MaxDYi/JD-Signal/6.Docs/问题记录/JD_Signal PCB问题.md

### V1.0

#### 问题：

1. Debug接口奇数与偶数接口需要对调。

2. 片上DAC输出未滤波。

3. ULN2003输出端未接外部电源。

4. RST键上端接VDD，无法复位。

### V1.1

#### 修改：

1. Debug接口奇数与偶数接口需要对调。
2. Debug接口增加标注丝印。
3. 片上DAC输出信号增加一级有源滤波。
4. 修改ULN2003 外部电源连接。
5. 修改RST键连接。
7. LED限流电阻改为1kΩ。
8. 增加VBAT供电电池。
9. 屏幕固定位置。

#### 问题：

1. ADC使用了低速通道。
2. DAC输出U4低通滤波器错误。
3. PGA两级的耦合电容删除。
4. U8与U10的封装过大。
5. CR2032电池座缺少定位孔。

### V1.2

#### 修改：

更换ADC通道。

删除PGA的SPI1_MISO引脚，改为只发送模式。

修正U4低通滤波器电路。

PGA两级的耦合电容替换为0欧电阻。

修改SWD时钟的丝印为SCK。

增加BOOT0按键。
