MaxDYi/JD-Signal/6.Docs/问题记录/SD卡存储说明.md

# SD卡存储说明

SD卡存储原始数据与计算结果。

原始数据与计算结果均保存至SD卡根目录的文件夹中，文件夹以任务开始时的时间戳命名，以系统RTC时间为准。

命名格式“YYYY\MM\DD_hh-mm-ss”。

## 1.原始数据

## 2.计算结果
