MaxDYi/JD-Signal/2.Hardware/JD-Signal-ASM/JD-Signal-BOM.xlsx

Comment | Description | Designator | Footprint | Quantity
1uF | 贴片电容/MLCC电容 | C1, C2, C3, C5, C6, C8, C10, C15, C17 | C0603_M | 9
100nF | 贴片电容/MLCC电容 | C4, C13, C14, C16, C18, C19, C20, C21, C22, C23, C26, C27, C28, C29, C30, C31, C32, C33, C34, C35, C36, C37, C38, C39, C41, C42 | C0603_M | 26
1.5pF | 贴片电容/MLCC电容 | C7, C9 | C0603_M | 2
8pF | 贴片电容/MLCC电容 | C11, C12 | C0603_M | 2
2.2uF | 贴片电容/MLCC电容 | C24, C25 | C0603_M | 2
1nF | 贴片电容/MLCC电容 | C40 | C0603_M | 1
VS10BQ015HM3 | 肖特基二极管 | D1, D2, D3, D4 | SMB | 4
1N4148 | High Conductance Fast Diode | D5, D6 | SOD-123 | 2
DEBUG PAD | 调试断点焊盘 | DE1, DE2, DE3 | DEBUG_B | 3
ESD | 瞬态电压抑制二极管 | DR1, DR2, DR3, DR4, DR5, DR6, DR7, DR8, DR9 | 0402 | 9
10uF/6.3V | 贴片钽电容 | E1, E2, E3, E4 | C_3216 | 4
IPORT-3 | IPORT-3 | IPORT1 | IPORT | 1
TF_Card | TF卡座 | J1 | Micro SD | 1
236-402 | No Description Available | J2, J3, J4, J5, J6, J7, J8, J9, J10, J11, J12, J13 | CONN_236-402_WAG | 12
CON-18P | 18P连接器 | JP1 | FPC0.5-WT-18P | 1
Header 5X2 | 5*2P接插件 | JP2 | HDR2.54-LI-2x5P | 1
HDR-1X3 | 3P接插件 | JP3 | HDR2.54-LI-3P | 1
RED | 贴片LED | LED1, LED13, LED14, LED15 | LED0603_R | 4
BLUE | 贴片LED | LED2, LED16 | LED0603_R | 2
GREEN | 贴片LED | LED3, LED4, LED5, LED6, LED7, LED8, LED9, LED10, LED11, LED12 | LED0603_R | 10
DC5V | 蜂鸣器 | LS1 | BEEP 5x9x5.5 | 1
S8550 | PNP General Purpose Amplifier | Q1 | SOT23 | 1
AO3400A | P-Channel JFET | Q2 | SOT23 | 1
S8050 | NPN General Purpose Amplifier | Q3 | SOT23 | 1
10K | 贴片电阻 | R1, R4, R5, R6, R7, R11, R12, R14, R21, R23, R26, R32, R34, R37, R38, R57 | R0603_M | 16
1K | 贴片电阻 | R2, R3, R35, R43, R46, R47, R48, R49, R54, R55, R60, R61, R62, R64, R65, R74, R79 | R0603_M | 17
47K | 贴片电阻 | R8, R9, R10, R24, R25 | R0603_M | 5
100K | 贴片电阻 | R13, R20 | R0603_M | 2
22R | 贴片电阻 | R15, R16, R17, R18, R19, R22 | R0603_M | 6
330R | 贴片电阻 | R27, R28 | R0603_M | 2
0R | 贴片电阻 | R29, R36, R40, R41, R42, R44, R45, R52, R53, R56, R59, R63, R66, R67, R69, R70, R71 | R0603_M | 17
0.01R | 贴片电阻 | R30, R31, R33 | HS25 | 3
10K | 贴片电阻 | R39 | R1210_M | 1
5.1K | 贴片电阻 | R50, R51 | R0603_M | 2
200K | 贴片电阻 | R58 | R0603_M | 1
470R | 贴片电阻 | R68, R77 | R0603_M | 2
0R | 贴片电阻 | R72, R73, R75, R76 | AXIAL0.5-1/2W | 4
22K | 贴片电阻 | R78 | R0603_M | 1
4.7K | 贴片电阻 | R80 | R0603_M | 1
G6B-2114P-US 12DC | No Description Available | RLA1, RLA2, RLA3, RLA4, RLA5 | RELAY_G6B-2114P_OMR | 5
VBAT | 纽扣电池 | S2 | CR2032 BS-5 | 1
M3铜柱 | 铜柱 | SP1, SP2, SP3, SP4 | M3x4+6_N | 4
4x4x1.5 | 贴片4x4轻触开关 | SW1, SW2, SW3 | SW SMD-3*6*2.5 | 3
DIP-SW-4P | 4路编码开关 | SW4 | SW DIP-4P | 1
TEST | 测试点 | TP1, TP2, TP4, TP6, TP7, TP8, TP9, TP10, TP11 | TEST 1.6 | 9
LT6658AIDE | No Description Available | U1 | MSOP16 | 1
STM32H750VBT6 | No Description Available | U2 | LQFP100-14*14 | 1
LT1632IS8 | No Description Available | U3, U4 | SO-8 | 2
AD620AN | CI-AD620AN | U5, U7, U12, U13 | SOIC-8 | 4
OPA548T-1 | No Description Available | U6 | TO-220-7 - 90*45 | 1
LTC6912IGN-1 | No Description Available | U8, U10 | SSOP-16 | 2
ULN2003AD | No Description Available | U9 | SOP16 | 1
CH340N | USB转串口芯片, 内置晶振 | U11 | SOIC-8 | 1
TYPE-C 2.0 -16P | USB2.0_Type-C_16Pin母座 | USBC1 | USB-C-SMD_16P | 1
AMS1117-3V3 | 三端稳压芯片 | V1, V2 | SOT89_L | 2
32.768KHz | 2脚无源晶振(谐振器） | X1 | XTAL-3215-2P | 1
12M | 4脚无源晶振(谐振器） | X2 | XTAL-3225-4P | 1
