MaxDYi/JD-Signal/2.Hardware/JD-Signal-PRJ/JD-Signal-SCH-V2.0.pdf

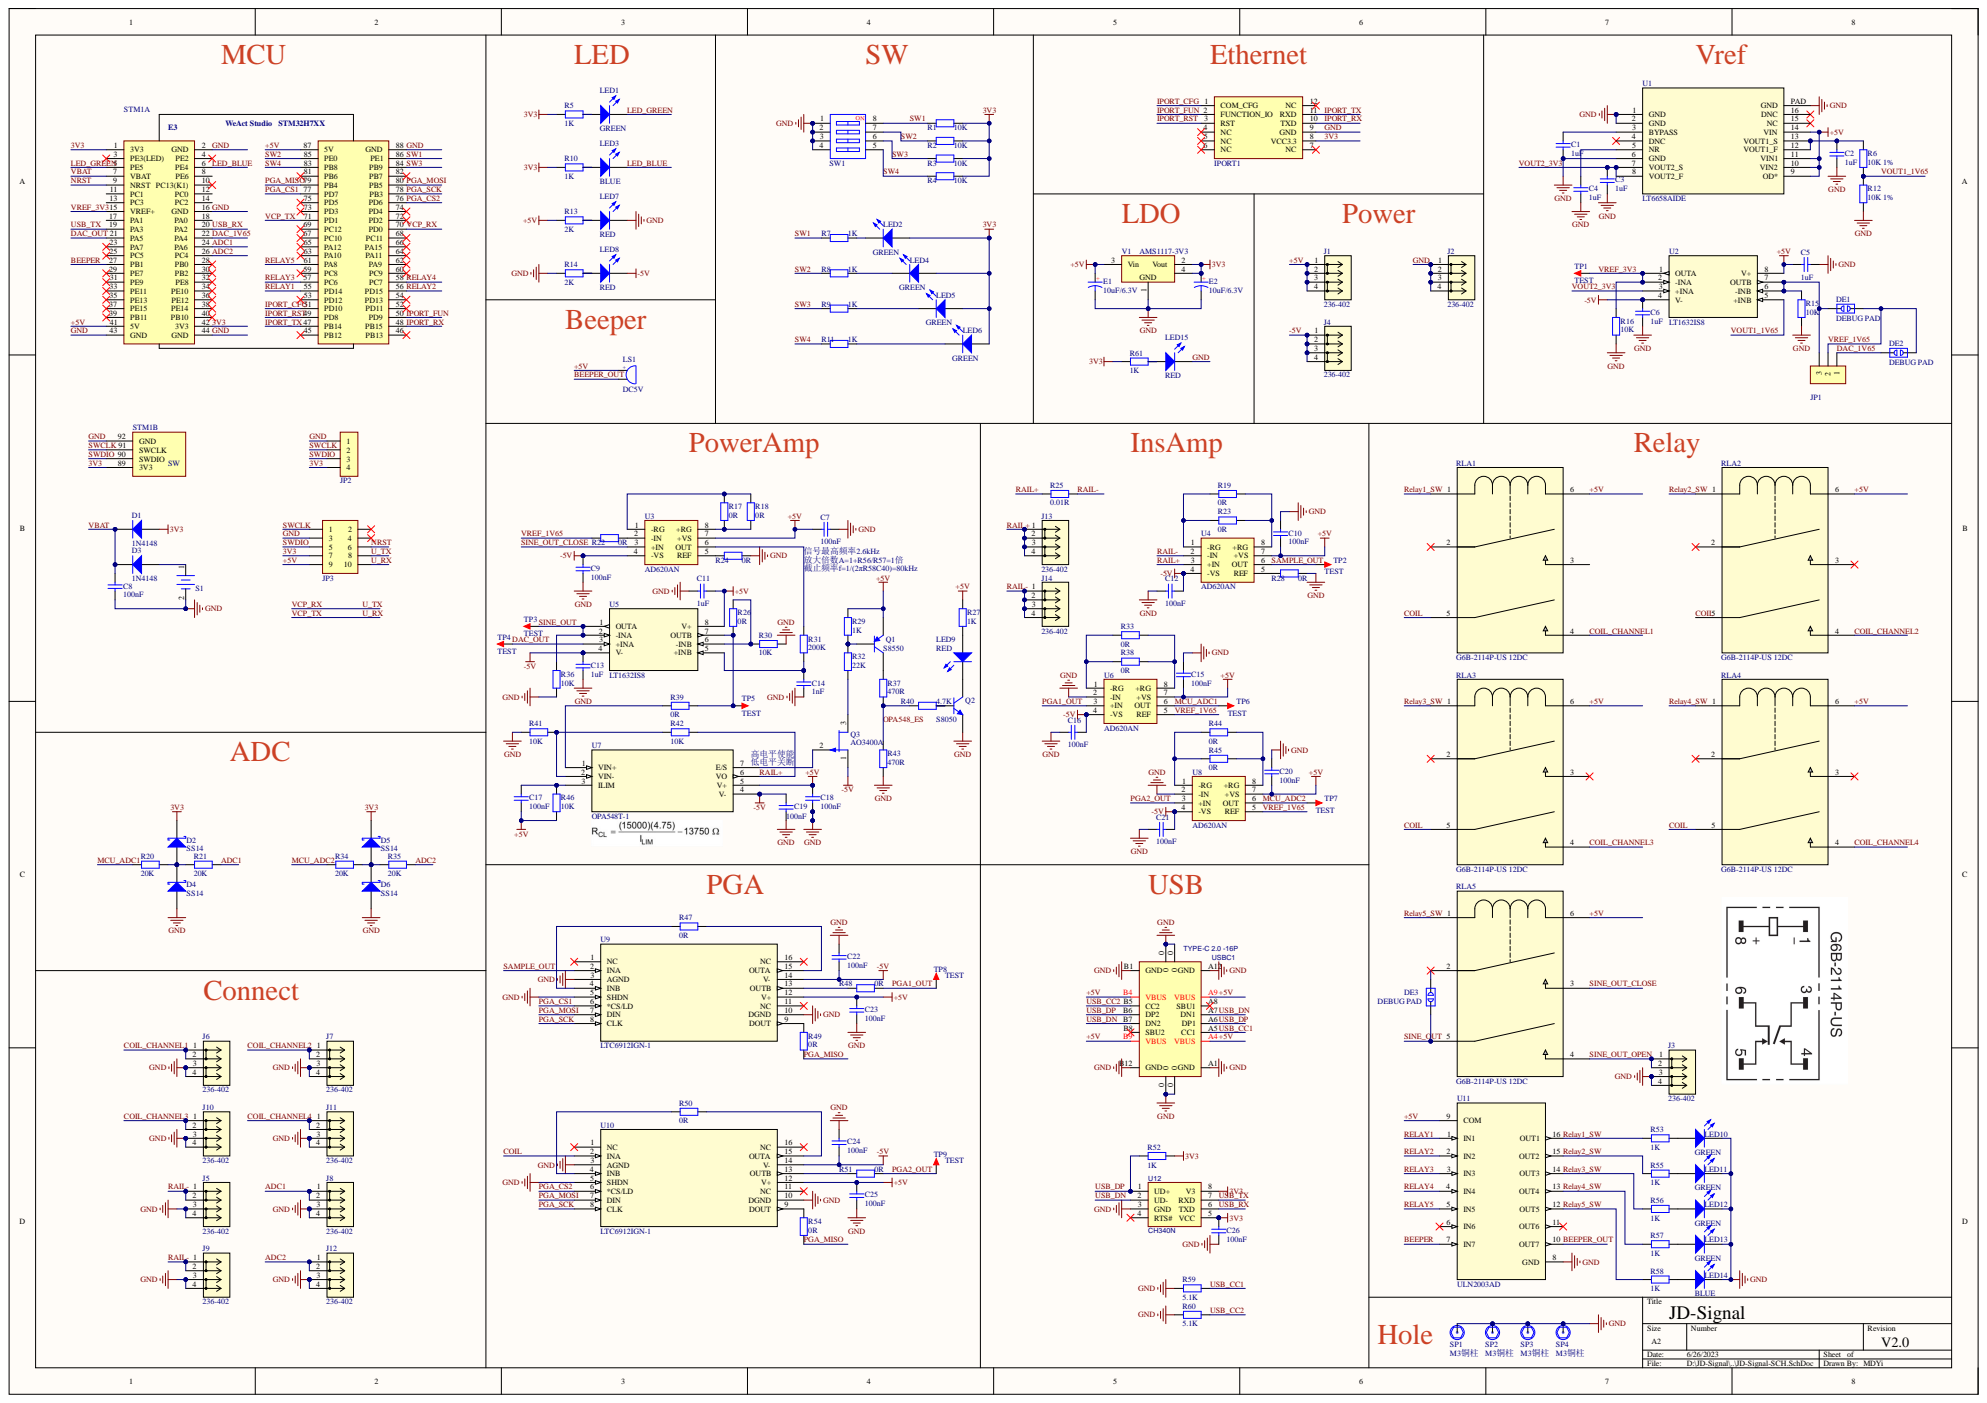
[picture p1: page 1]
