MaxDYi/JD-Signal/2.Hardware/JD-Signal-ASM/JD-Signal-V1.2-装配图.pdf

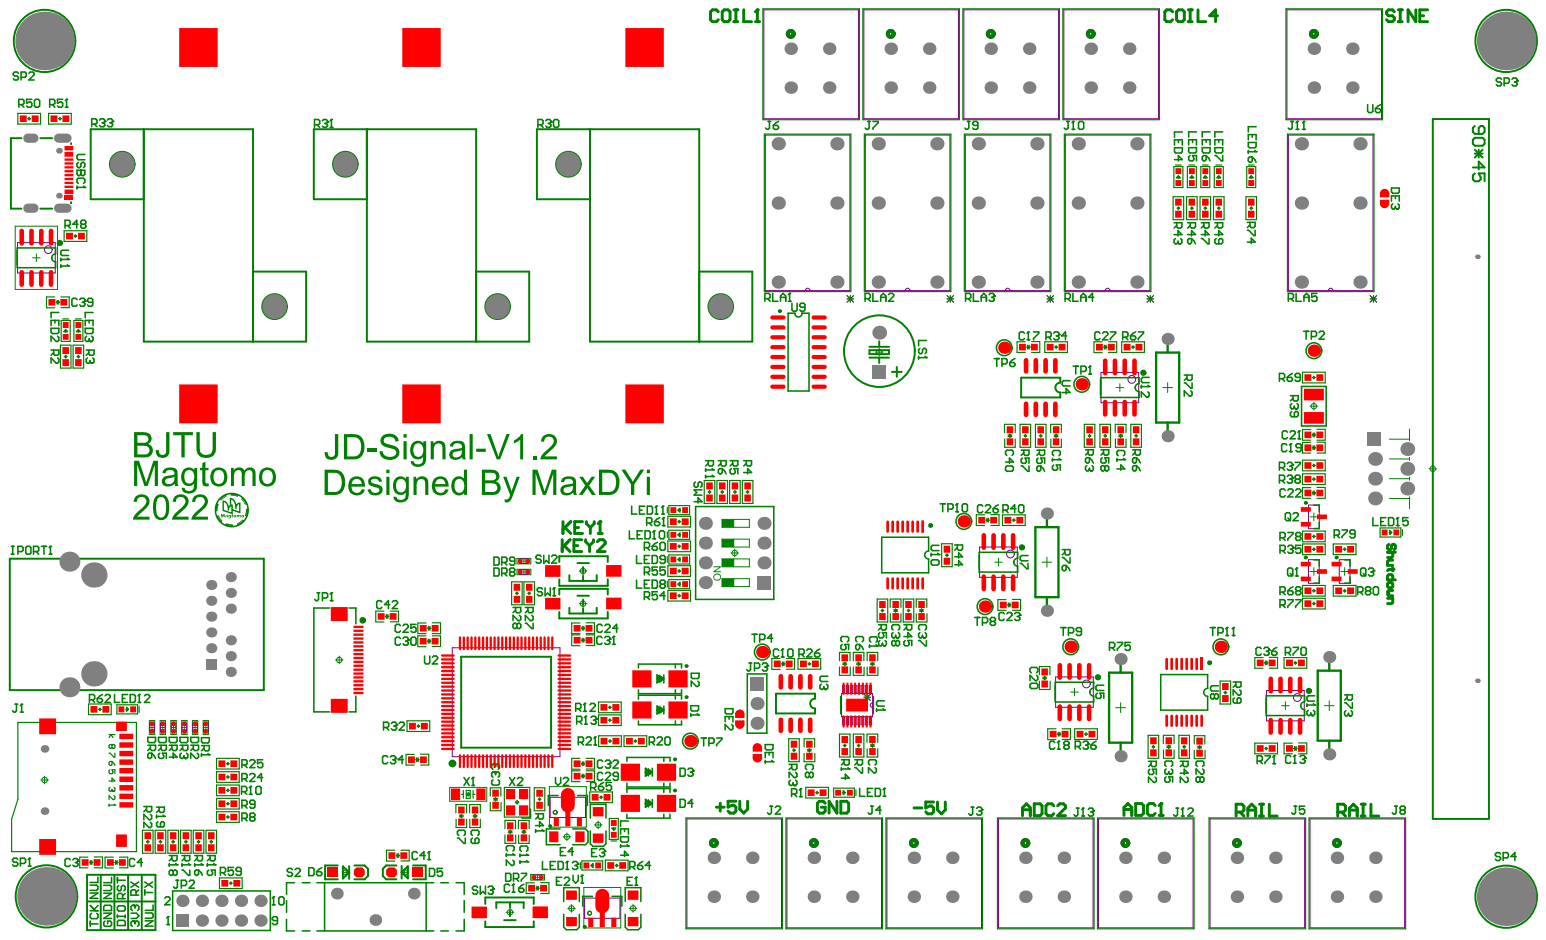
[picture p2: page 1]

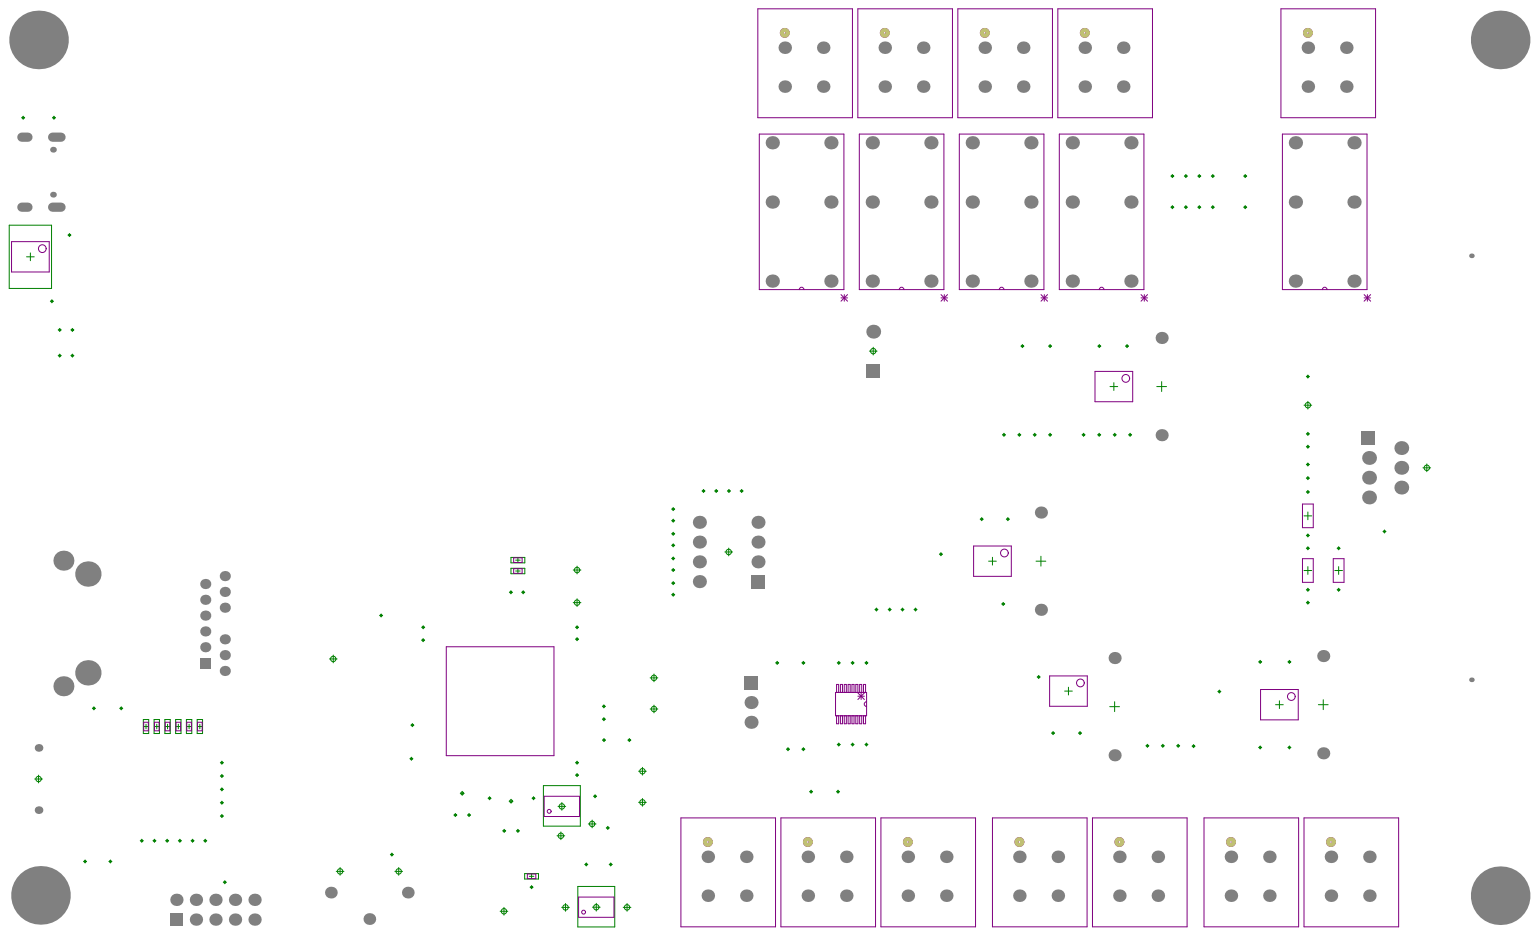
[picture p3: page 2]
