MaxDYi/JD-Signal/6.Docs/电路图/JD-Signal-SCH_V1.2.pdf

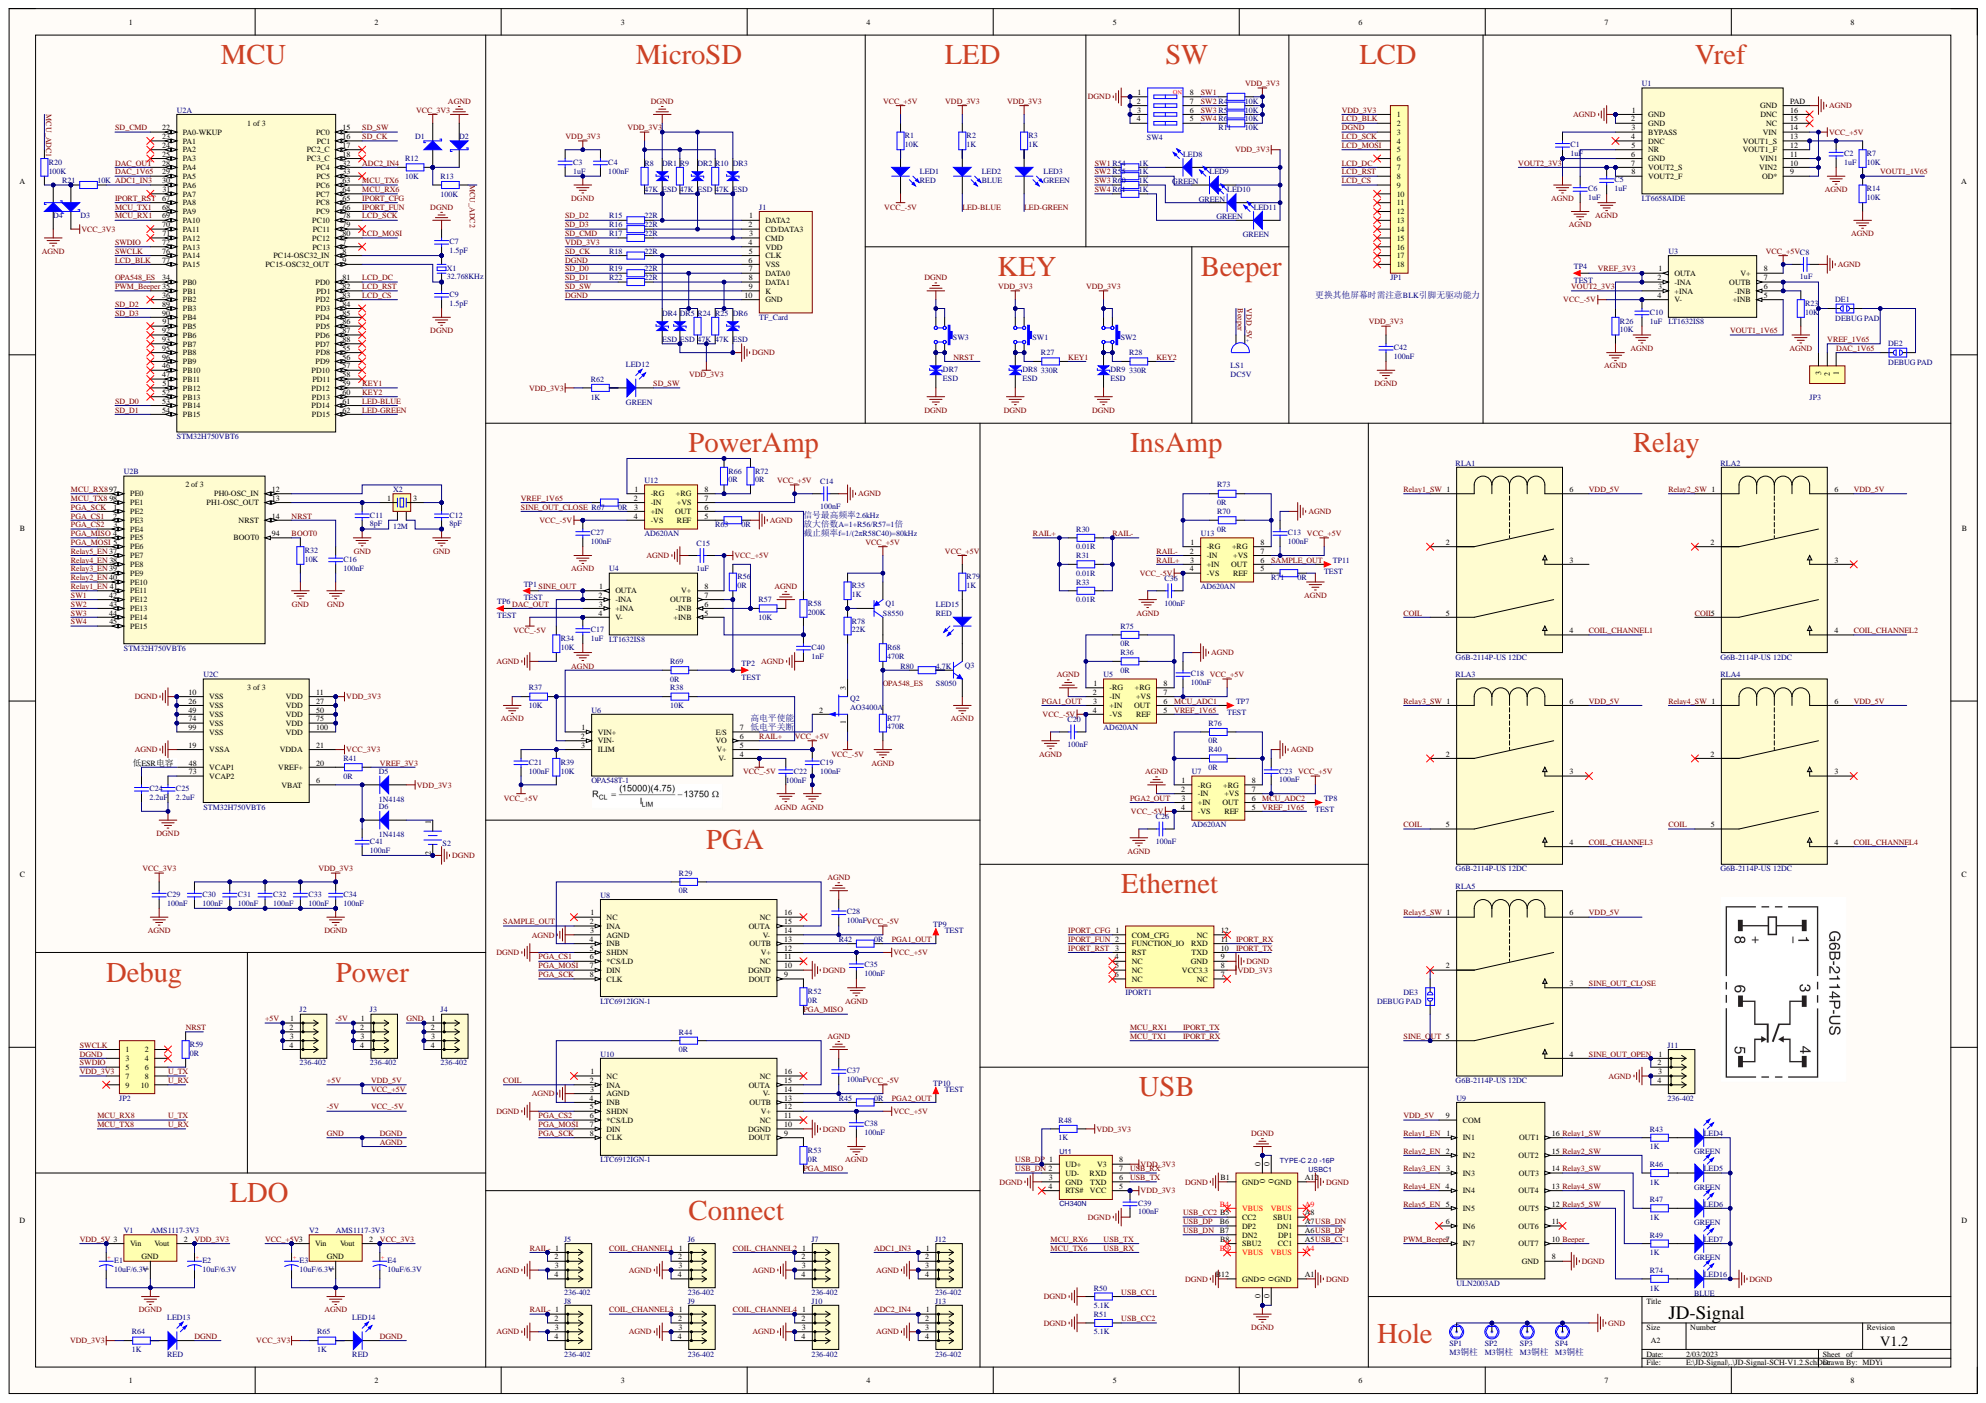
[picture p4: page 1]
