MaxDYi/JD-Signal/6.Docs/电路图/JD-Signal-SCH_V1.0.pdf

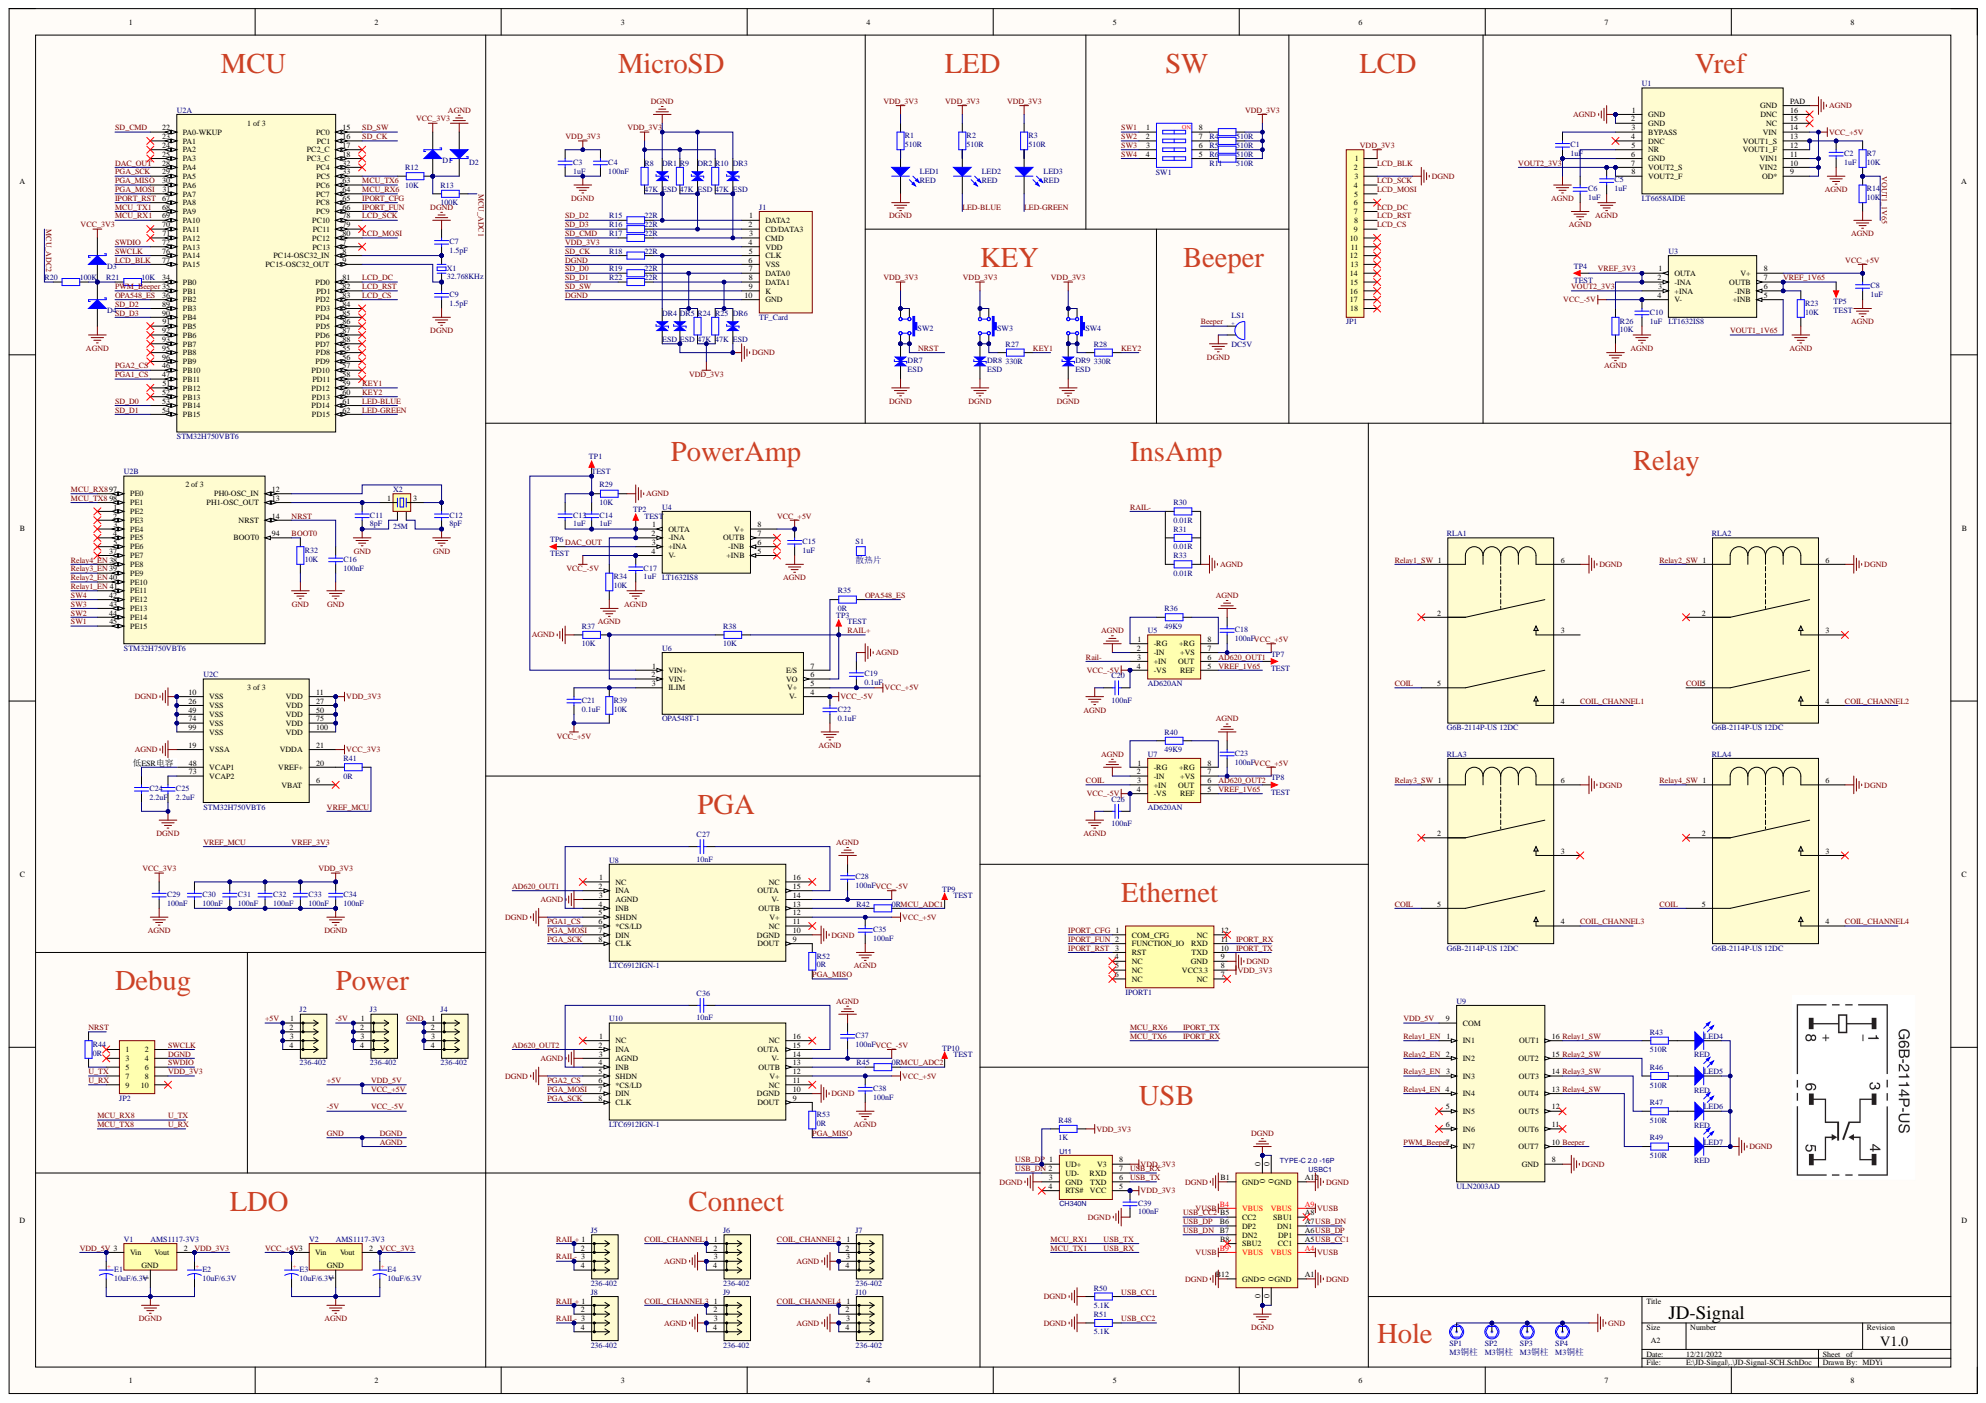
[picture p5: page 1]
