MaxDYi/JD-Signal/6.Docs/电路图/JD-Signal-SCH_V1.1.pdf

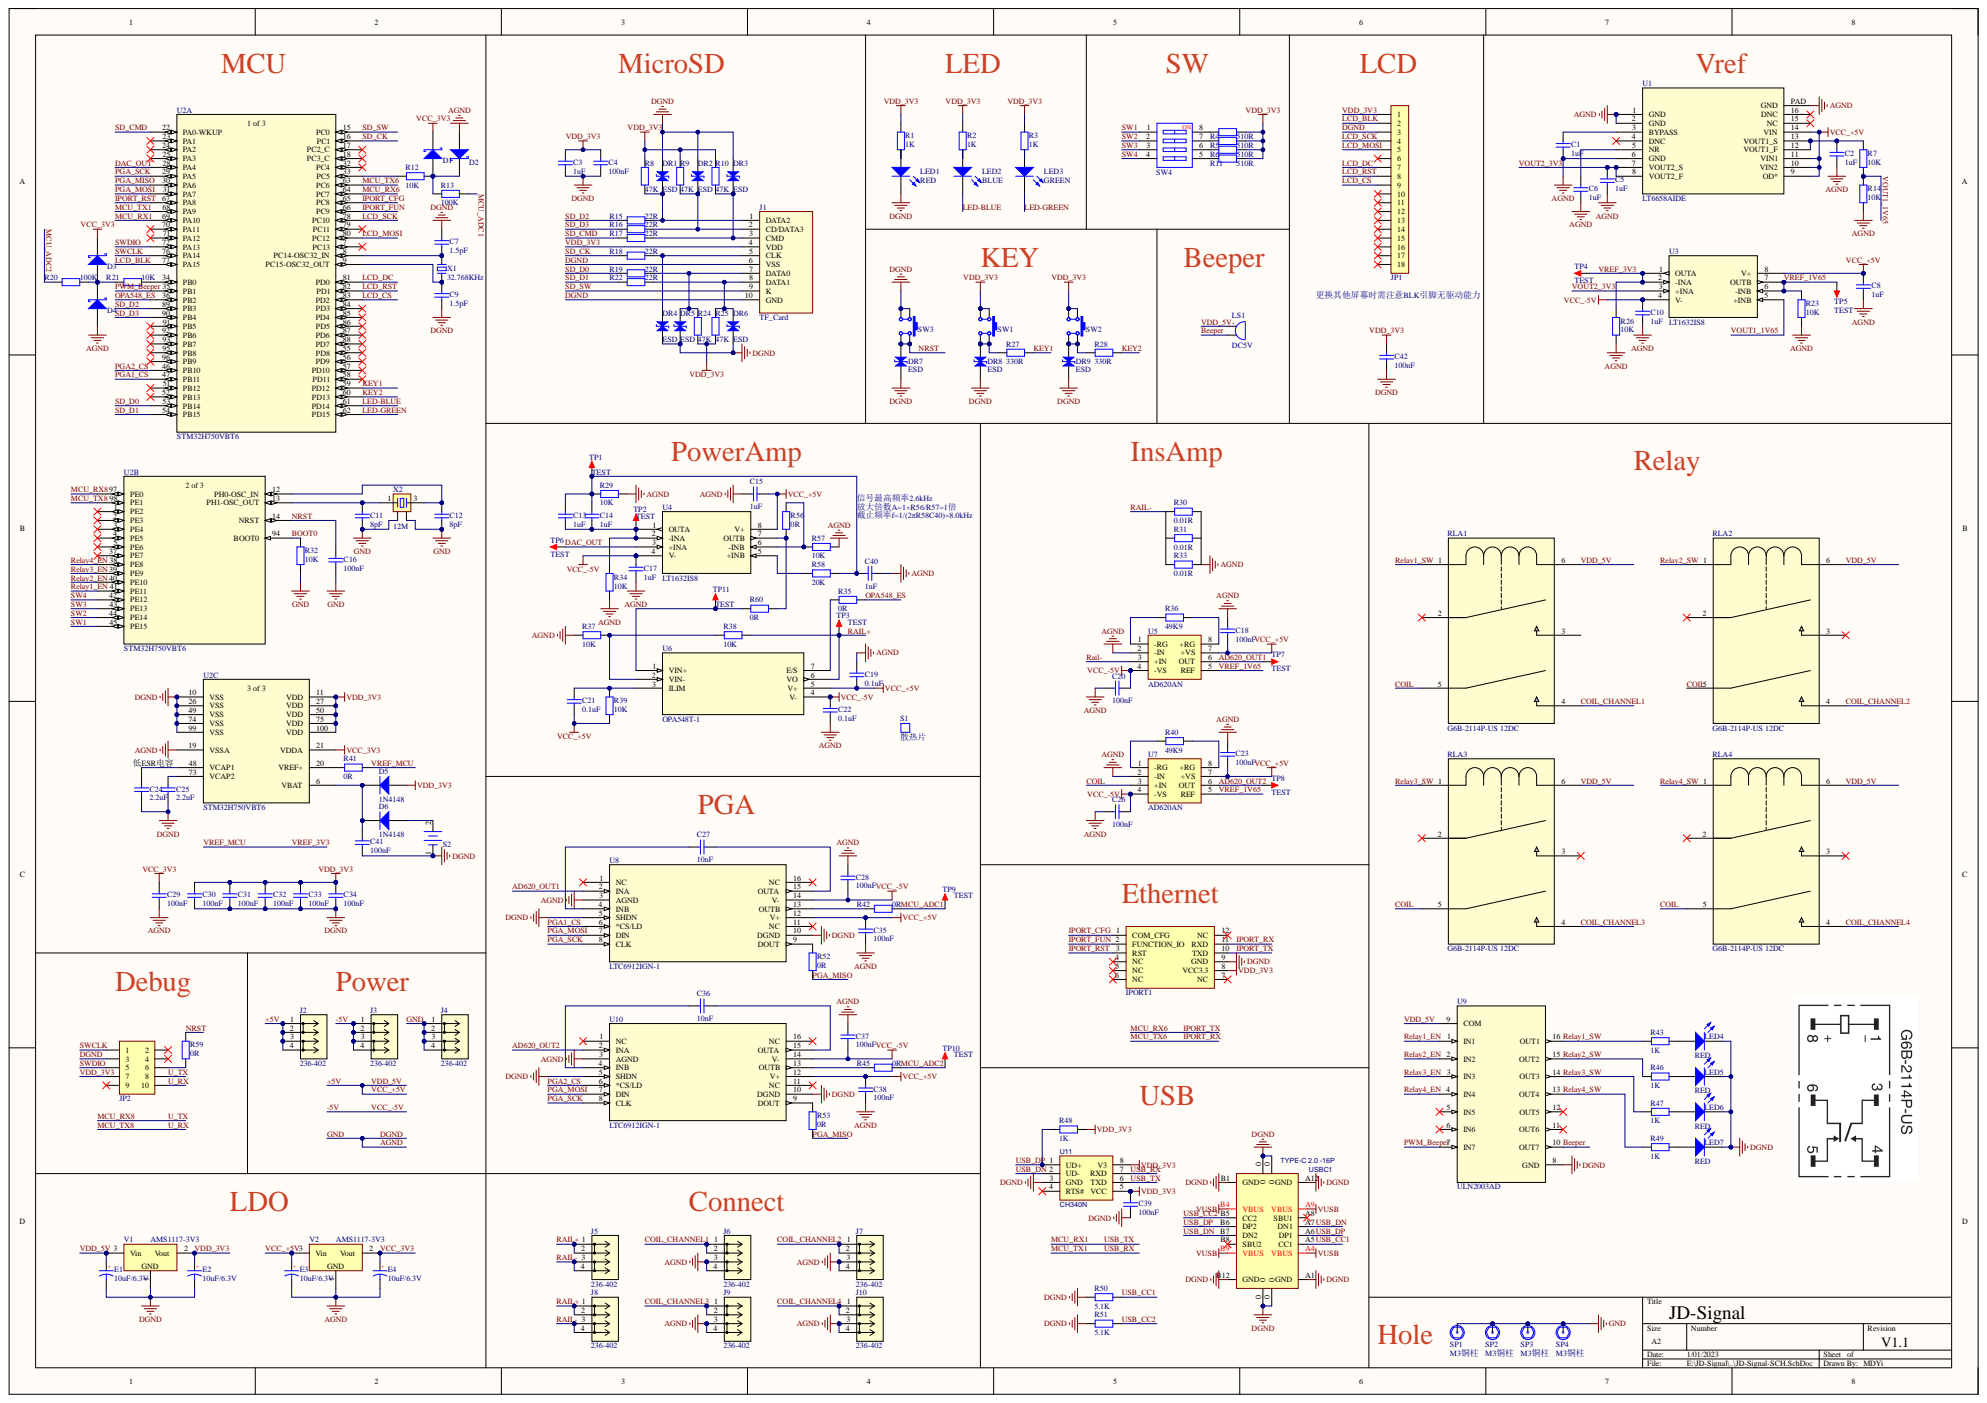
[picture p6: page 1]
