MaxDYi/JD-Signal/(list of files, drawings)

Other design files:
2.Hardware/JD-Signal-PRJ/JD-Signal.SchDoc
2.Hardware/JD-Signal-PRJ/JD-Singal.PrjPcb
2.Hardware/JD-Signal-PRJ/Librarys/JD-Signal.SchLib
