MaxDYi/JD-Signal/3.Firmware/JD-Signal/Core/Src/main.c

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
/* Includes ------------------------------------------------------------------*/
#include "main.h"
#include "cmsis_os.h"
#include "adc.h"
#include "dac.h"
#include "dma.h"
#include "fatfs.h"
#include "quadspi.h"
#include "rtc.h"
#include "sdmmc.h"
#include "spi.h"
#include "tim.h"
#include "usart.h"
#include "usb_otg.h"
#include "gpio.h"

/* USER CODE BEGIN Includes */
#include "stdio.h"
#include "math.h"
#include "arm_math.h"
#include "arm_const_structs.h"
#include "Algorithm.h"
#include "BodeSetting.h"
#include "cJSON.h"
#include "LCD.h"
#include "lcd_init.h"
#include "LTC6912.h"
#include "SaveInCSV.h"
#include "SD.h"
#include "UserInteraction.h"
/* USER CODE END Includes */


void SystemClock_Config(void);
void PeriphCommonClock_Config(void);
void MX_FREERTOS_Init(void);
/**
 * @brief  The application entry point.
 * @retval int
 */
int main(void)
{
    /* Enable I-Cache---------------------------------------------------------*/
    SCB_EnableICache();

    /* MCU Configuration--------------------------------------------------------*/

    /* Reset of all peripherals, Initializes the Flash interface and the Systick. */
    HAL_Init();

    /* Configure the system clock */
    SystemClock_Config();

    /* Configure the peripherals common clocks */
    PeriphCommonClock_Config();

    /* Initialize all configured peripherals */
    MX_GPIO_Init();
    MX_DMA_Init();
    MX_DAC1_Init();
    MX_TIM3_Init();
    MX_TIM6_Init();
    MX_USART1_UART_Init();
    MX_ADC3_Init();
    MX_RTC_Init();
    MX_FATFS_Init();
    MX_ADC1_Init();
    MX_TIM4_Init();
    MX_ADC2_Init();
    MX_SPI4_Init();
    MX_QUADSPI_Init();
    MX_SDMMC1_SD_Init();
    MX_SPI1_Init();
    MX_UART4_Init();
    MX_USART2_UART_Init();
    MX_USB_OTG_FS_USB_Init();
    /* USER CODE BEGIN 2 */
    printf("\r\nJD-Signal\r\n");

    HAL_ADCEx_Calibration_Start(&hadc1, ADC_CALIB_OFFSET, ADC_SINGLE_ENDED);
    HAL_ADCEx_Calibration_Start(&hadc2, ADC_CALIB_OFFSET, ADC_SINGLE_ENDED);
    HAL_ADCEx_Calibration_Start(&hadc3, ADC_CALIB_OFFSET, ADC_SINGLE_ENDED);

    HAL_ADCEx_Calibration_Start(&hadc1, ADC_CALIB_OFFSET_LINEARITY, ADC_SINGLE_ENDED);
    HAL_ADCEx_Calibration_Start(&hadc2, ADC_CALIB_OFFSET_LINEARITY, ADC_SINGLE_ENDED);
    HAL_ADCEx_Calibration_Start(&hadc3, ADC_CALIB_OFFSET_LINEARITY, ADC_SINGLE_ENDED);

    LED_Init();
    Relay_Init();
    HAL_Delay(100);
    Relay_On(4);

    Vref_Init();
    Sine_Init(1000, 50);
    Sine_OutputEn(1);

    LCD_Init();
    LCD_Fill(0, 0, LCD_W, LCD_H, BLACK);
    LCD_ShowString(2, 2, "JD-Signal", WHITE, BLACK, 16, 0);

    // LTC6912_SetGain(2, 1);
    // LTC6912_SetGain(2, 2);
    /* USER CODE END 2 */

    /* Call init function for freertos objects (in freertos.c) */
    MX_FREERTOS_Init();

    /* Start scheduler */
    osKernelStart();
    /* We should never get here as control is now taken by the scheduler */
    /* Infinite loop */
    /* USER CODE BEGIN WHILE */
    while (1)
    {
        /* USER CODE END WHILE */

        /* USER CODE BEGIN 3 */
    }
    /* USER CODE END 3 */
}

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
/**
 * @brief  Period elapsed callback in non blocking mode
 * @note   This function is called  when TIM1 interrupt took place, inside
 * HAL_TIM_IRQHandler(). It makes a direct call to HAL_IncTick() to increment
 * a global variable "uwTick" used as application time base.
 * @param  htim : TIM handle
 * @retval None
 */
void HAL_TIM_PeriodElapsedCallback(TIM_HandleTypeDef *htim)
{
    if (htim->Instance == TIM1)
    {
        HAL_IncTick();
    }
}

/**
 * @brief  This function is executed in case of error occurrence.
 * @retval None
 */
void Error_Handler(void)
{
}

#ifdef USE_FULL_ASSERT
/**
 * @brief  Reports the name of the source file and the source line number
 *         where the assert_param error has occurred.
 * @param  file: pointer to the source file name
 * @param  line: assert_param error line source number
 * @retval None
 */
void assert_failed(uint8_t *file, uint32_t line)
{
}
#endif /* USE_FULL_ASSERT */
