MaxDYi/JD-Signal/3.Firmware/JD-Signal/JD-Signal.ioc

Mcu.UserName=STM32H750VBTx
PA10.GPIO_Label=USB_ID
PA10.Signal=USB_OTG_FS_ID
PA11.GPIO_Label=USB_DN
PA11.Signal=USB_OTG_FS_DM
PA12.GPIO_Label=USB_DP
PA12.Signal=USB_OTG_FS_DP
PA2.GPIO_Label=USB_TX
PA2.Signal=USART2_TX
PA3.GPIO_Label=USB_RX
PA3.Signal=USART2_RX
PA4.GPIO_Label=DAC_1V65
PA4.Signal=COMP_DAC11_group
PA5.GPIO_Label=DAC_SINE
PA5.Signal=COMP_DAC12_group
PA6.Signal=ADCx_INP3
PA8.GPIO_Label=RELAY5
PA8.Signal=GPIO_Output
PB1.GPIO_Label=BEEPER
PB1.Signal=S_TIM3_CH4
PB14.GPIO_Label=IPORT_TX
PB14.Signal=USART1_TX
PB15.GPIO_Label=IPORT_RX
PB15.Signal=USART1_RX
PB2.GPIO_Label=QSPI_BK_CLK
PB2.Signal=QUADSPI_CLK
PB5.GPIO_Label=PGA_MOSI
PB5.Signal=SPI1_MOSI
PB6.GPIO_Label=QSPI_BK_NCS
PB6.Signal=QUADSPI_BK1_NCS
PB8.GPIO_Label=SW4
PB8.Signal=GPIO_Input
PB9.GPIO_Label=SW3
PB9.Signal=GPIO_Input
PC10.GPIO_Label=SD_D2
PC10.Signal=SDMMC1_D2
PC11.GPIO_Label=SD_D3
PC11.Signal=SDMMC1_D3
PC12.GPIO_Label=SD_CK
PC12.Signal=SDMMC1_CK
PC13.GPIO_Label=KEY1
PC13.Signal=GPXTI13
PC4.Signal=ADCx_INP4
PC6.GPIO_Label=RELAY3
PC6.Signal=GPIO_Output
PC7.GPIO_Label=RELAY4
PC7.Signal=GPIO_Output
PC8.GPIO_Label=SD_D0
PC8.Signal=SDMMC1_D0
PC9.GPIO_Label=SD_D1
PC9.Signal=SDMMC1_D1
PD0.GPIO_Label=VCP_RX
PD0.Signal=UART4_RX
PD1.GPIO_Label=VCP_TX
PD1.Signal=UART4_TX
PD10.GPIO_Label=IPORT_CFG
PD10.Signal=GPIO_Output
PD11.GPIO_Label=QSPI_BK_IO0
PD11.Signal=QUADSPI_BK1_IO0
PD12.GPIO_Label=QSPI_BK_IO1
PD12.Signal=QUADSPI_BK1_IO1
PD13.GPIO_Label=QSPI_BK_IO3
PD13.Signal=QUADSPI_BK1_IO3
PD14.GPIO_Label=RELAY1
PD14.Signal=GPIO_Output
PD15.GPIO_Label=RELAY2
PD15.Signal=GPIO_Output
PD2.GPIO_Label=SD_CMD
PD2.Signal=SDMMC1_CMD
PD4.GPIO_Label=SD_SW
PD4.Signal=GPIO_Input
PD6.GPIO_Label=PGA_CS2
PD6.Signal=GPIO_Output
PD7.GPIO_Label=PGA_CS1
PD7.Signal=GPIO_Output
PD8.GPIO_Label=IPORT_RST
PD8.Signal=GPIO_Output
PD9.GPIO_Label=IPORT_FUN
PD9.Signal=GPIO_Output
PE0.GPIO_Label=SW2
PE0.Signal=GPIO_Input
PE1.GPIO_Label=SW1
PE1.Signal=GPIO_Input
PE10.GPIO_Label=LCD_BLK
PE10.Signal=GPIO_Output
PE11.GPIO_Label=LCD_CS
PE11.Signal=SPI4_NSS
PE12.GPIO_Label=LCD_SCK
PE12.Signal=SPI4_SCK
PE13.GPIO_Label=LCD_DC
PE13.Signal=GPIO_Output
PE14.GPIO_Label=LCD_SDA
PE14.Signal=SPI4_MOSI
PE2.GPIO_Label=QSPI_BK_IO2
PE2.Signal=QUADSPI_BK1_IO2
PE3.GPIO_Label=LED_SYS
PE3.Signal=GPIO_Output
PE4.GPIO_Label=LED_BLUE
PE4.Signal=GPIO_Output
PE5.GPIO_Label=LED_GREEN
PE5.Signal=GPIO_Output
