MaxDYi/JD-Signal/3.Firmware/JD-Signal/Drivers/LCD/lcd_init.h

#ifndef __LCD_INIT_H
#define __LCD_INIT_H

#include "main.h"
#include "spi.h"

#define LCD_SPI_PORT hspi4

#define USE_HORIZONTAL 3 // 设置横屏或者竖屏显示 0或1为竖屏 2或3为横屏

#if USE_HORIZONTAL == 0 || USE_HORIZONTAL == 1
#define LCD_W 80
#define LCD_H 160

#else
#define LCD_W 160
#define LCD_H 80
#endif

//-----------------LCD端口定义----------------
/*
#define LCD_SCLK_Clr() HAL_GPIO_WritePin(LCD_SCK_GPIO_Port, LCD_SCK_Pin, GPIO_PIN_RESET) // SCL=SCLK
#define LCD_SCLK_Set() HAL_GPIO_WritePin(LCD_RST_GPIO_Port, LCD_RST_Pin, GPIO_PIN_SET)

#define LCD_MOSI_Clr() HAL_GPIO_WritePin(LCD_SDA_GPIO_Port, LCD_SDA_Pin, GPIO_PIN_RESET) // SDA=MOSI
#define LCD_MOSI_Set() HAL_GPIO_WritePin(LCD_RST_GPIO_Port, LCD_RST_Pin, GPIO_PIN_SET)

#define LCD_RES_Clr() HAL_GPIO_WritePin(LCD_RST_GPIO_Port, LCD_RST_Pin, GPIO_PIN_RESET) // RES
#define LCD_RES_Set() HAL_GPIO_WritePin(LCD_RST_GPIO_Port, LCD_RST_Pin, GPIO_PIN_SET)
*/
#define LCD_DC_Clr() HAL_GPIO_WritePin(LCD_DC_GPIO_Port, LCD_DC_Pin, GPIO_PIN_RESET) // DC
#define LCD_DC_Set() HAL_GPIO_WritePin(LCD_DC_GPIO_Port, LCD_DC_Pin, GPIO_PIN_SET)

#define LCD_CS_Clr() HAL_GPIO_WritePin(LCD_CS_GPIO_Port, LCD_CS_Pin, GPIO_PIN_RESET) // CS
#define LCD_CS_Set() HAL_GPIO_WritePin(LCD_CS_GPIO_Port, LCD_CS_Pin, GPIO_PIN_SET)

#define LCD_BLK_Clr() HAL_GPIO_WritePin(LCD_BLK_GPIO_Port, LCD_BLK_Pin, GPIO_PIN_SET) // BLK
#define LCD_BLK_Set() HAL_GPIO_WritePin(LCD_BLK_GPIO_Port, LCD_BLK_Pin, GPIO_PIN_RESET)
// 初始化GPIO
void LCD_Writ_Bus(uint8_t dat);                                           // 模拟SPI时序
void LCD_WR_DATA8(uint8_t dat);                                           // 写入一个字节
void LCD_WR_DATA(uint16_t dat);                                           // 写入两个字节
void LCD_WR_REG(uint8_t dat);                                             // 写入一个指令
void LCD_Address_Set(uint16_t x1, uint16_t y1, uint16_t x2, uint16_t y2); // 设置坐标函数
void LCD_Init(void);                                                      // LCD初始化
#endif
