MaxDYi/JD-Signal/(commit log)

2023-05-10 V1.2版本硬件
    [JD-Signal-BOM.xlsx, JD-Signal-SCH-V1.2.SchDoc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]
2023-05-10 未使用FreeRTOS版本
2023-05-10 芯片手册
2023-05-10 旧版设计图
2023-05-16 FreeRTOS版本
2023-05-22 串口DMA空闲中断
2023-05-24 CJSON任务使用任务通知
2023-06-07 串口不定长接收完成，CJSON解析后屏幕不刷新未解决
2023-06-16 lcd不亮，fatfs无法保存
2023-06-20 DAC输出波形不对
2023-06-22 V2.0版
    [JD-Signal-SCH-V1.2.SchDoc, JD-Signal-SCH-V2.0.SchDoc, JD-Signal.SchLib, JD-Singal.PrjPcb]
2023-06-25 6月25日初版完成稿
    [JD-Signal-SCH-V2.0.SchDoc, JD-Singal.PrjPcb]
2023-06-26 V2.0完成版
    [JD-Signal-SCH-V2.0.SchDoc, JD-Signal.SchDoc, JD-Singal.PrjPcb]
2023-07-04 板子回来
